jonathan512/stm32_cycloidal_robotic_arm/Core/Inc/main.h

#define B1_Pin GPIO_PIN_13
#define B1_GPIO_Port GPIOC
#define USART_TX_Pin GPIO_PIN_2
#define USART_TX_GPIO_Port GPIOA
#define USART_RX_Pin GPIO_PIN_3
#define USART_RX_GPIO_Port GPIOA
#define LD2_Pin GPIO_PIN_5
#define LD2_GPIO_Port GPIOA
#define PWM_TIM1_CH1_Pin GPIO_PIN_8
#define PWM_TIM1_CH1_GPIO_Port GPIOA
#define STEPPER_EN_Pin GPIO_PIN_4
#define STEPPER_EN_GPIO_Port GPIOB
#define STEPPER_DIR_Pin GPIO_PIN_10
#define STEPPER_DIR_GPIO_Port GPIOB
#define TMS_Pin GPIO_PIN_13
#define TMS_GPIO_Port GPIOA
#define TCK_Pin GPIO_PIN_14
#define TCK_GPIO_Port GPIOA
#define SWO_Pin GPIO_PIN_3
#define SWO_GPIO_Port GPIOB
#define JOY1_X_Pin GPIO_PIN_1
#define JOY1_X_GPIO_Port GPIOC
#define JOY1_Y_Pin GPIO_PIN_2
#define JOY1_Y_GPIO_Port GPIOC
#define JOY2_X_Pin GPIO_PIN_3
#define JOY2_X_GPIO_Port GPIOC
#define JOY2_Y_Pin GPIO_PIN_4
#define JOY2_Y_GPIO_Port GPIOC
#define JOY1_SEL_Pin GPIO_PIN_5
#define JOY1_SEL_GPIO_Port GPIOC
#define JOY2_SEL_Pin GPIO_PIN_1
#define JOY2_SEL_GPIO_Port GPIOB
