jonathan512/stm32_cycloidal_robotic_arm/Core/Src/tim.c

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
/* Includes ------------------------------------------------------------------*/
#include "tim.h"

TIM_HandleTypeDef htim2;
TIM_HandleTypeDef htim4;
TIM_HandleTypeDef htim5;
TIM_HandleTypeDef htim10;

void HAL_TIM_MspPostInit(TIM_HandleTypeDef* timHandle);

/* TIM2 init function */
void MX_TIM2_Init(void)
{

  TIM_ClockConfigTypeDef sClockSourceConfig = {0};
  TIM_MasterConfigTypeDef sMasterConfig = {0};
  TIM_OC_InitTypeDef sConfigOC = {0};

  htim2.Instance = TIM2;
  htim2.Init.Prescaler = 83;
  htim2.Init.CounterMode = TIM_COUNTERMODE_UP;
  htim2.Init.Period = 1999;
  htim2.Init.ClockDivision = TIM_CLOCKDIVISION_DIV1;
  htim2.Init.AutoReloadPreload = TIM_AUTORELOAD_PRELOAD_DISABLE;
  if (HAL_TIM_Base_Init(&htim2) != HAL_OK)
  {
    Error_Handler();
  }

  sClockSourceConfig.ClockSource = TIM_CLOCKSOURCE_INTERNAL;
  if (HAL_TIM_ConfigClockSource(&htim2, &sClockSourceConfig) != HAL_OK)
  {
    Error_Handler();
  }

  if (HAL_TIM_PWM_Init(&htim2) != HAL_OK)
  {
    Error_Handler();
  }

  sMasterConfig.MasterOutputTrigger = TIM_TRGO_RESET;
  sMasterConfig.MasterSlaveMode = TIM_MASTERSLAVEMODE_DISABLE;
  if (HAL_TIMEx_MasterConfigSynchronization(&htim2, &sMasterConfig) != HAL_OK)
  {
    Error_Handler();
  }

  sConfigOC.OCMode = TIM_OCMODE_PWM1;
  sConfigOC.Pulse = 1000;
  sConfigOC.OCPolarity = TIM_OCPOLARITY_HIGH;
  sConfigOC.OCFastMode = TIM_OCFAST_DISABLE;
  if (HAL_TIM_PWM_ConfigChannel(&htim2, &sConfigOC, TIM_CHANNEL_1) != HAL_OK)
  {
    Error_Handler();
  }

  HAL_TIM_MspPostInit(&htim2);

}

/* TIM4 init function */
void MX_TIM4_Init(void)
{

  TIM_ClockConfigTypeDef sClockSourceConfig = {0};
  TIM_MasterConfigTypeDef sMasterConfig = {0};
  TIM_OC_InitTypeDef sConfigOC = {0};

  htim4.Instance = TIM4;
  htim4.Init.Prescaler = 83;
  htim4.Init.CounterMode = TIM_COUNTERMODE_UP;
  htim4.Init.Period = 1999;
  htim4.Init.ClockDivision = TIM_CLOCKDIVISION_DIV1;
  htim4.Init.AutoReloadPreload = TIM_AUTORELOAD_PRELOAD_DISABLE;
  if (HAL_TIM_Base_Init(&htim4) != HAL_OK)
  {
    Error_Handler();
  }

  sClockSourceConfig.ClockSource = TIM_CLOCKSOURCE_INTERNAL;
  if (HAL_TIM_ConfigClockSource(&htim4, &sClockSourceConfig) != HAL_OK)
  {
    Error_Handler();
  }

  if (HAL_TIM_PWM_Init(&htim4) != HAL_OK)
  {
    Error_Handler();
  }

  sMasterConfig.MasterOutputTrigger = TIM_TRGO_RESET;
  sMasterConfig.MasterSlaveMode = TIM_MASTERSLAVEMODE_DISABLE;
  if (HAL_TIMEx_MasterConfigSynchronization(&htim4, &sMasterConfig) != HAL_OK)
  {
    Error_Handler();
  }

  sConfigOC.OCMode = TIM_OCMODE_PWM1;
  sConfigOC.Pulse = 1000;
  sConfigOC.OCPolarity = TIM_OCPOLARITY_HIGH;
  sConfigOC.OCFastMode = TIM_OCFAST_DISABLE;
  if (HAL_TIM_PWM_ConfigChannel(&htim4, &sConfigOC, TIM_CHANNEL_1) != HAL_OK)
  {
    Error_Handler();
  }

  HAL_TIM_MspPostInit(&htim4);

}

/* TIM5 init function */
void MX_TIM5_Init(void)
{

  TIM_ClockConfigTypeDef sClockSourceConfig = {0};
  TIM_MasterConfigTypeDef sMasterConfig = {0};
  TIM_OC_InitTypeDef sConfigOC = {0};

  htim5.Instance = TIM5;
  htim5.Init.Prescaler = 83;
  htim5.Init.CounterMode = TIM_COUNTERMODE_UP;
  htim5.Init.Period = 1999;
  htim5.Init.ClockDivision = TIM_CLOCKDIVISION_DIV1;
  htim5.Init.AutoReloadPreload = TIM_AUTORELOAD_PRELOAD_DISABLE;
  if (HAL_TIM_Base_Init(&htim5) != HAL_OK)
  {
    Error_Handler();
  }

  sClockSourceConfig.ClockSource = TIM_CLOCKSOURCE_INTERNAL;
  if (HAL_TIM_ConfigClockSource(&htim5, &sClockSourceConfig) != HAL_OK)
  {
    Error_Handler();
  }

  if (HAL_TIM_PWM_Init(&htim5) != HAL_OK)
  {
    Error_Handler();
  }

  sMasterConfig.MasterOutputTrigger = TIM_TRGO_RESET;
  sMasterConfig.MasterSlaveMode = TIM_MASTERSLAVEMODE_DISABLE;
  if (HAL_TIMEx_MasterConfigSynchronization(&htim5, &sMasterConfig) != HAL_OK)
  {
    Error_Handler();
  }

  sConfigOC.OCMode = TIM_OCMODE_PWM1;
  sConfigOC.Pulse = 1000;
  sConfigOC.OCPolarity = TIM_OCPOLARITY_HIGH;
  sConfigOC.OCFastMode = TIM_OCFAST_DISABLE;
  if (HAL_TIM_PWM_ConfigChannel(&htim5, &sConfigOC, TIM_CHANNEL_2) != HAL_OK)
  {
    Error_Handler();
  }

  HAL_TIM_MspPostInit(&htim5);

}

/* TIM10 init function */
void MX_TIM10_Init(void)
{

  TIM_ClockConfigTypeDef sClockSourceConfig = {0};
  TIM_OC_InitTypeDef sConfigOC = {0};

  htim10.Instance = TIM10;
  htim10.Init.Prescaler = 83;
  htim10.Init.CounterMode = TIM_COUNTERMODE_UP;
  htim10.Init.Period = 1999;
  htim10.Init.ClockDivision = TIM_CLOCKDIVISION_DIV1;
  htim10.Init.AutoReloadPreload = TIM_AUTORELOAD_PRELOAD_DISABLE;
  if (HAL_TIM_Base_Init(&htim10) != HAL_OK)
  {
    Error_Handler();
  }

  sClockSourceConfig.ClockSource = TIM_CLOCKSOURCE_INTERNAL;
  if (HAL_TIM_ConfigClockSource(&htim10, &sClockSourceConfig) != HAL_OK)
  {
    Error_Handler();
  }

  if (HAL_TIM_PWM_Init(&htim10) != HAL_OK)
  {
    Error_Handler();
  }

  sConfigOC.OCMode = TIM_OCMODE_PWM1;
  sConfigOC.Pulse = 1000;
  sConfigOC.OCPolarity = TIM_OCPOLARITY_HIGH;
  sConfigOC.OCFastMode = TIM_OCFAST_DISABLE;
  if (HAL_TIM_PWM_ConfigChannel(&htim10, &sConfigOC, TIM_CHANNEL_1) != HAL_OK)
  {
    Error_Handler();
  }

  HAL_TIM_MspPostInit(&htim10);

}

void HAL_TIM_Base_MspInit(TIM_HandleTypeDef* tim_baseHandle)
{

  if (tim_baseHandle->Instance == TIM2)
  {
    /* TIM2 clock enable */
    __HAL_RCC_TIM2_CLK_ENABLE();
    /* USER CODE BEGIN TIM2_MspInit 1 */
    HAL_NVIC_SetPriority(TIM2_IRQn, 1, 0);
    HAL_NVIC_EnableIRQ(TIM2_IRQn);

    /* USER CODE END TIM2_MspInit 1 */
  }
  else if (tim_baseHandle->Instance == TIM4)
  {
    /* TIM4 clock enable */
    __HAL_RCC_TIM4_CLK_ENABLE();
    /* USER CODE BEGIN TIM4_MspInit 1 */
    HAL_NVIC_SetPriority(TIM4_IRQn, 1, 0);
    HAL_NVIC_EnableIRQ(TIM4_IRQn);

    /* USER CODE END TIM4_MspInit 1 */
  }
  else if (tim_baseHandle->Instance == TIM5)
  {
    /* TIM5 clock enable */
    __HAL_RCC_TIM5_CLK_ENABLE();
    /* USER CODE BEGIN TIM5_MspInit 1 */
    HAL_NVIC_SetPriority(TIM5_IRQn, 1, 0);
    HAL_NVIC_EnableIRQ(TIM5_IRQn);

    /* USER CODE END TIM5_MspInit 1 */
  }
  else if (tim_baseHandle->Instance == TIM10)
  {
    /* TIM10 clock enable */
    __HAL_RCC_TIM10_CLK_ENABLE();
    /* USER CODE BEGIN TIM10_MspInit 1 */
    HAL_NVIC_SetPriority(TIM1_UP_TIM10_IRQn, 1, 1);
    HAL_NVIC_EnableIRQ(TIM1_UP_TIM10_IRQn);

    /* USER CODE END TIM10_MspInit 1 */
  }
}

void HAL_TIM_MspPostInit(TIM_HandleTypeDef* timHandle)
{

  GPIO_InitTypeDef GPIO_InitStruct = {0};
  if (timHandle->Instance == TIM2)
  {
    __HAL_RCC_GPIOA_CLK_ENABLE();
    /**TIM2 GPIO Configuration
    PA15     ------> TIM2_CH1
    */
    GPIO_InitStruct.Pin = GPIO_PIN_15;
    GPIO_InitStruct.Mode = GPIO_MODE_AF_PP;
    GPIO_InitStruct.Pull = GPIO_NOPULL;
    GPIO_InitStruct.Speed = GPIO_SPEED_FREQ_LOW;
    GPIO_InitStruct.Alternate = GPIO_AF1_TIM2;
    HAL_GPIO_Init(GPIOA, &GPIO_InitStruct);

  }
  else if (timHandle->Instance == TIM4)
  {
    __HAL_RCC_GPIOB_CLK_ENABLE();
    /**TIM4 GPIO Configuration
    PB6     ------> TIM4_CH1
    */
    GPIO_InitStruct.Pin = GPIO_PIN_6;
    GPIO_InitStruct.Mode = GPIO_MODE_AF_PP;
    GPIO_InitStruct.Pull = GPIO_NOPULL;
    GPIO_InitStruct.Speed = GPIO_SPEED_FREQ_LOW;
    GPIO_InitStruct.Alternate = GPIO_AF2_TIM4;
    HAL_GPIO_Init(GPIOB, &GPIO_InitStruct);

  }
  else if (timHandle->Instance == TIM5)
  {
    __HAL_RCC_GPIOA_CLK_ENABLE();
    /**TIM5 GPIO Configuration
    PA1     ------> TIM5_CH2
    */
    GPIO_InitStruct.Pin = GPIO_PIN_1;
    GPIO_InitStruct.Mode = GPIO_MODE_AF_PP;
    GPIO_InitStruct.Pull = GPIO_NOPULL;
    GPIO_InitStruct.Speed = GPIO_SPEED_FREQ_LOW;
    GPIO_InitStruct.Alternate = GPIO_AF2_TIM5;
    HAL_GPIO_Init(GPIOA, &GPIO_InitStruct);

  }
  else if (timHandle->Instance == TIM10)
  {
    __HAL_RCC_GPIOB_CLK_ENABLE();
    /**TIM10 GPIO Configuration
    PB8     ------> TIM10_CH1
    */
    GPIO_InitStruct.Pin = GPIO_PIN_8;
    GPIO_InitStruct.Mode = GPIO_MODE_AF_PP;
    GPIO_InitStruct.Pull = GPIO_NOPULL;
    GPIO_InitStruct.Speed = GPIO_SPEED_FREQ_LOW;
    GPIO_InitStruct.Alternate = GPIO_AF3_TIM10;
    HAL_GPIO_Init(GPIOB, &GPIO_InitStruct);

  }
}

void HAL_TIM_Base_MspDeInit(TIM_HandleTypeDef* tim_baseHandle)
{

  if (tim_baseHandle->Instance == TIM2)
  {
    /* Peripheral clock disable */
    __HAL_RCC_TIM2_CLK_DISABLE();
    HAL_NVIC_DisableIRQ(TIM2_IRQn);

  }
  else if (tim_baseHandle->Instance == TIM4)
  {
    /* Peripheral clock disable */
    __HAL_RCC_TIM4_CLK_DISABLE();
    HAL_NVIC_DisableIRQ(TIM4_IRQn);

  }
  else if (tim_baseHandle->Instance == TIM5)
  {
    /* Peripheral clock disable */
    __HAL_RCC_TIM5_CLK_DISABLE();
    HAL_NVIC_DisableIRQ(TIM5_IRQn);

  }
  else if (tim_baseHandle->Instance == TIM10)
  {
    /* Peripheral clock disable */
    __HAL_RCC_TIM10_CLK_DISABLE();
    HAL_NVIC_DisableIRQ(TIM1_UP_TIM10_IRQn);

  }
}
